kimilucky-ic/flyvis-fpga-competition/src/neural/README.md

# Final neural compute source

Eight RTL modules and fifty unchanged memory/map images for the current complete-network implementation. Arithmetic, topology and update order are unchanged by directory consolidation. Original/exported hashes are in ../../build/portable/relocation_manifest.json (its historical `neural/` labels now resolve to this directory).

Use ../../build/portable/prepare.py and its documented stages; do not launch isolated legacy scripts. Runtime firmware remains paired in ../../board/runtime/app/bundle/.
