kimilucky-ic/flyvis-fpga-competition/report/release_review.md

# Repository delivery and publication boundary

Updated 2026-11-02. The source delivery exists in `kimilucky-ic/flyvis-fpga-competition`; it is now PUBLIC (verified 2026-11-02); the original conversations remain withdrawn. Current completion adds a corrected seven-page report, selected safe current engineering exchanges, official vendor acquisition instructions and aligned entry documentation. This update does not change repository visibility.

## Evidence retained

Existing software sample and fresh-session preparation checks, normalized file admission/JS syntax, historical RTL/implementation reports and the saved 1090-step analysis retain their own original evidence levels. Current documentation changes do not rerun or strengthen those results. The original engineering workspace, RAR and accepted neural/runtime/firmware files are untouched. Parent Git commit is the rollback point.

## Public-release blockers

- The 28 ALIENTEK source instances in [third_party_holds.json](third_party_holds.json) and relevant derived artifacts have no verified redistribution grant. Official download links provide a source locator, not a replacement license.
- Current official archive-to-BIT and clean-machine Vivado reproduction have not been validated; exact vendor-derived bytes may require the matching reference revision.
- Earlier private conversations stay withdrawn. [Selected collaboration evidence](ai_collaboration_record.md) contains only short current engineering exchanges and labelled editorial corrections, not a full historical chat export.

The team authorized updating the existing repository materials. This update does not change visibility, run hardware experiments or contact the vendor. Repository contents, current software checks and publication clearance are separate claims.
