kimilucky-ic/flyvis-fpga-competition/third_party_notices.md

# Attribution and licensing

The root MIT license applies to original team-authored contributions only. Third-party code, headers, generated tool files and data retain their upstream notices and terms; the root license does not override them.

FlyVis: https://github.com/TuragaLab/flyvis and Lappalainen et al., Nature (2024), https://doi.org/10.1038/s41586-024-07939-3 . The upstream MIT notice is retained in the current bundle. Model authorship and training belong to the original authors. Exported model provenance is in original_model_provenance.json.

AMD Vivado/PYNQ IP and ALIENTEK board camera example dependencies remain subject to their original licenses. Reconstruct vendor IP with licensed Vivado and use the original working PYNQ2.7 vendor SD image. This repository does not license or distribute Vivado, the SD image or vendor tool binaries. Retain source-header notices when reusing historical examples.
