kimilucky-ic/flyvis-fpga-competition/report/ai_engineering_cases.md

# FlyVis工程协作案例（脱敏节选）

更新：2026-10-30。本页补充实际研发内容。前两个案例仅摘取已核对的短提示和对应回答；问题、修正与结果段为编辑整理。后两个案例全部为工程档案摘要，没有补写缺失的对话。省略全部本机路径、人员信息、私人言论、会话标识、认证信息及无关上下文；未恢复完整历史聊天。

本轮仅整理保存的材料，没有重跑GPU、摄像头、板卡或Vivado。证据级别随原记录保留。历史版本的成功和限制不自动等于当前版本验收。

## 案例1：恢复正确的固件加载与内存申请顺序

记录形式：短原文节选＋工程整理。

用户提示（原文节选）：

> 同意，恢复以前成功的顺序，先加载固件再申请内存，失败就退出不启动计算。把错误提示也改好，先做软件验证，改完给我新的Notebook，板端我来运行，别再让我反复试错了。

模型回答（原文节选）：

> **核对身份和独占状态 → 加载固件 → 实际申请并校验内存 → 成功后才配置、启动神经计算。**

**问题与反馈（整理）：**原流程在加载Overlay前申请内存，PYNQ 2.7返回Overlay is not downloaded；CmaFree也不能单独作为实际分配能力的判断。

**修正方法（整理）：**恢复依赖顺序，申请失败即退出；错误说明必须区分固件是否加载、内存是否分配及神经计算是否开始。

**验证与边界（整理）：**原保存报告记录6项初始化/失败路径软件测试、3类输入提示检查，Python 3.8语法及配对身份检查通过。实际内存申请当时未执行；不能称为板测通过。

[对应工程证据](evidence/initialization_cpu.json)

## 案例2：让T4/T5显示保留真实数值与科学含义

记录形式：短原文节选＋工程整理。

用户提示（原文节选）：

> 那就把中央T4/T5八个亚型的曲线和这个方向偏好解释加到现有GUI右边文字区，别再只显示721节点均值，不改布局、不重跑实验，让评委能直接看懂亮边缘和暗边缘分别是谁在响应。把节点均值换成中央T4T5啊。

模型回答（原文节选）：

> **已经改好：原GUI右侧的八条曲线，已从“每类721节点均值”换成“中央T4/T5八个亚型的真实活动”。布局不变，不需要重跑实验。**

**问题与反馈（整理）：**空间均值可能掩盖局部响应；带符号的模型活动、整流后的展示曲线和方向偏好容易被混淆。

**修正方法（整理）：**在该历史版本显示中央节点的max(activity,0)曲线，同时保留带符号原始值；不做逐帧归一化，不把历史GPU方向分析标成当前运行新算的指标。

**验证与边界（整理）：**这是历史GUI修改的对话证据；原回答提到970步既有ON/OFF数据核对，本次未重新执行该核对，不将对话中的数值单独提升为新验证结果。后续区域均值版本有独立定义，不能与本案例混称。

[对应工程证据](https://github.com/kimilucky-ic/flyvis-fpga-competition/tree/archive/full-development-before-slim/src/flyvis_runtime/fly/viewer/competition_full_pl.js)

## 案例3：FP32优化：数值正确之后仍须修复布线时序

记录形式：工程档案摘要，非逐字对话。

**问题与反馈（整理）：**保存的工程说明记载：首版跳过无效空间坐标的候选数值通过，但100MHz完整SoC布线WNS为−1.171ns，80个建立端点失败。原始完整提示与回答未纳入本次材料。

**修正方法（整理）：**为裁剪行描述符增加寄存器，使用pending标签和ready标志对齐同步读取；在背压下保持描述符、映射与标签同步，保留原源节点ID和边顺序。

**验证与边界（整理）：**保存比较报告：45,669节点、1,513,231条有序边；基线2,284,304周期，候选2,201,418周期，减少3.6285%；修复版完整SoC布线WNS+0.139ns、建立端点失败0。周期改善和布线结果均不是物理板速实测。

[对应工程证据](evidence/fp32_pipeline_comparison.json)

## 案例4：DDR环形记录：减少内存，保留持久化后释放

记录形式：工程档案摘要，非逐字对话。

**问题与反馈（整理）：**持续记录需要有限内存；不能覆盖尚未可靠保存的状态，也不能把PC接收确认误当成板端槽位释放。原始完整提示与回答未纳入本次材料。

**修正方法（整理）：**64槽循环记录，按16步批处理持久化；前台只在保存线程确认持久化完成后释放连续记录。槽满产生背压，回绕不重置神经状态，错误或未知状态不自动重试。

**验证与边界（整理）：**保存的CPU/Verilator报告记录：DDR由95.953125MiB改为11.5MiB；完整网络5步核对228,345状态字、差异0。另有既有1090步操作者记录的离线审核，属于不同证据，不能把本报告当作新实板运行。

[对应工程证据](evidence/ddr_ring_summary.json)

## 阅读与复核

[结构化案例](ai_engineering_cases.json)保留相同内容。[此前交付记录](ai_collaboration_record.md)仅用于仓库核查，不再作为主要研发案例。脱敏后的短节选不代表提供了完整历史原始对话。
