kimilucky-ic/flyvis-fpga-competition/report/collaboration_selected.md

# 脱敏研发协作记录

正式报告中的本路径对应[四个工程案例](ai_engineering_cases.md)，短原文与档案摘要分列；[离线阅读版](ai_engineering_cases.html)。不提供完整私人对话。
