kimilucky-ic/flyvis-fpga-competition/report/ai_workflow.md

# AI工程协作材料

主要研发案例见[脱敏工程案例](ai_engineering_cases.md)，[离线阅读版](ai_engineering_cases.html)可直接本机打开。[结构化记录](ai_engineering_cases.json)与正文一致。

两个案例有短提示/回答原文节选，两个为明确标记的工程档案摘要；不编造缺失回答，不恢复完整私人聊天。[既有仓库交付记录](ai_collaboration_record.md)单独保留。早先JSON均仍为回顾摘要。

本页不改变已有报告的原证据级别；没有运行任何设备或新科学实验。
