kimilucky-ic/flyvis-fpga-competition/report/ai_collaboration_record.md

# Selected engineering collaboration record — 2026-10-29

Scope: repository completeness and documentation delivery only. The quotations below are short verbatim excerpts from the current task, selected for the user's request to complete the GitHub deliverable. All feedback and correction paragraphs are editorial summaries, not reconstructed historical dialogue. This is not a full transcript or proof of complete historical AI records. Earlier withdrawn conversations stay withdrawn.

## Case 1: scope, repository visibility and actual upload verification

User instruction (verbatim):

> 不用你只需要管github上有没有提交完全

Assistant response (verbatim):

> 明白，只核查GitHub仓库：确认代码、报告、验证数据、构建与运行说明、Skill是否都已推送，以及有没有漏传或过时内容。不检查比赛官网，也不改仓库公开状态。

Actual tool feedback (short verbatim excerpts):

```text
GitHub API error 404
"visibility":"PRIVATE"
"sha":"064c1606684568d5976b82cf9acce2fc8d9ddcef"
"files":10754
"truncated":false
```

Correction and verification (summary): the connected API returned 404 for the private repository. That was not treated as proof that the repository or files were missing. The already-authorized GitHub CLI account read the repository metadata, main commit and full recursive tree. The remote commit matched the local reviewed commit. Read-only verification confirmed the runtime entry and nine report files. Visibility stayed private. This was a delivery check, not a hardware test.

## Case 2: complete the deliverable without restoring private conversations

User instruction (verbatim):

> 那就把这些都补上

Assistant response (verbatim):

> 我会补齐GitHub里的报告、说明和依赖获取步骤，先核实哪些厂家文件已有明确许可。AI协作部分只选与工程有关的脱敏记录，不恢复整段私人聊天；无法确认的许可和复建结果会如实标明。仓库继续保持私有。

Implementation and verification (summary): preserve the accepted neural, firmware and runtime files; correct outdated README/reproduction statements; add the seven-page report with current repository visibility and record scope; add official vendor acquisition instructions and the existing 56-file identity check. File/link/hash checks, PDF rendering and remote-commit checks are the intended acceptance for this documentation change. No fabricated past model answers or new physical results are added.

## Workflow and boundaries

Human sets scope → inspect actual files and source evidence → preserve accepted code → make minimal documentation changes → validate links, hashes and rendered report → inspect the exact commit → push to the same private repository → verify remote commit. No autonomous agent or device operation is required. A failed/unknown experiment is never retried by this documentation workflow. The quoted exchanges describe this delivery task; older Skill cases retain their own evidence and limitations.
