kimilucky-ic/flyvis-fpga-competition/skill/report_extract.md

# 可并入设计报告的Skill提炼说明

## 提炼来源

本包来自板级交互、工具链复位/位宽问题、图与数值契约、量化比较、GPU/PL反馈、展示对齐、受控替换、能耗口径及证据保留等实际工作。具体失败、纠正及历史报告对应关系见14项validation.md、collaboration-records.md和source_review_20261018.md；后两者为整理摘要，不是完整原对话。

## 如何验证有效

先确认原案例的目标/版本/输入和输出身份，再保留成功与失败，不以console PASS单独作证明。包内原始记录与摘要逐项标注，source_manifest.json记录hash。案例包含实际板上回放、实际GPU运算、CPU对照、RTL仿真和估算，各自范围分别表述。2026-10-21仅做文件/格式/来源审核，没有新板测或模型计算。

## 如何确定边界

量化任务分数不等价于完整内部状态一致；回放不等于闭环；估算不等于板级功耗；特定GPU/板卡成功不等于跨板通用。Windows路径只有用户观察，原失败日志不足。所有参数化模板的独立复用尚未完成，见validation_gaps.md。

## 他人使用路径

从README.md选择相应项，填写usage.md所需目标与契约，按skill.md步骤在获准任务中使用，保留reuse_record.json记录。用预先确定的门限和原始证据判断成功/失败，不照搬本项目的地址/bitstream/hash。完整历史实验的工程、数据和工具须另行合法获得；本包不是完整实验源码。

此节可纳入3.3.5.3的“提炼过程”，不能代替整份设计报告或完整LLM交互附件。
