kimilucky-ic/flyvis-fpga-competition/build/portable/vendor_file_map.md

# Platform dependency file map

All 56 matching files are already included in `src/vendor`; no vendor download is required for the offline prepare step. Run from the repository root:

```text
python build/portable/prepare.py --vendor-dir src/vendor --output ../flyvis_build
```

The first column is the exact path relative to the accepted vendor project working directory, not an independently verified location inside today's manufacturer archive. Official download and version limits remain in [vendor dependency review](../vendor_dependency_review.md). Some metadata is generated by the vendor project. The archive-internal paths have not been verified, so they are not invented here.

| Required vendor-relative file | Bundled file | SHA256 |
| --- | --- | --- |
| `base.bd` | [src/vendor/base.bd](../../src/vendor/base.bd) | `a08877266a865cdf75d5c5047701cd81b9b72199ded3a373683df26e48c40b7c` |
| `base.xdc` | [src/vendor/base.xdc](../../src/vendor/base.xdc) | `c79dcbc456922482ab0d6adf72560cd75552ea30a078e663b3640884c2776b49` |
| `ov5640_lcd.tcl` | [src/vendor/ov5640_lcd.tcl](../../src/vendor/ov5640_lcd.tcl) | `69524d4433c1b1718ea8e8ad9bf8af4eb3550cee7b4196bf206c34afbb5335c9` |
| `ov5640_lcd.xdc` | [src/vendor/ov5640_lcd.xdc](../../src/vendor/ov5640_lcd.xdc) | `c62a2a8bc13933be10ddce5fbaf6409dd815fe9937c075d44b8e259e6da00182` |
| `bd_xci/ip/base_auto_cc_0/base_auto_cc_0.xci` | [src/vendor/bd_xci/ip/base_auto_cc_0/base_auto_cc_0.xci](../../src/vendor/bd_xci/ip/base_auto_cc_0/base_auto_cc_0.xci) | `876a5273ebf8daf60ccf3d9f35fd5de3859664417b6a995de6d6e4e8c88ef673` |
| `bd_xci/ip/base_auto_pc_0/base_auto_pc_0.xci` | [src/vendor/bd_xci/ip/base_auto_pc_0/base_auto_pc_0.xci](../../src/vendor/bd_xci/ip/base_auto_pc_0/base_auto_pc_0.xci) | `1a972976e8166c1a9832acf68daef37545088bcb073cfe2463fcb00d0e1b1245` |
| `bd_xci/ip/base_auto_pc_1/base_auto_pc_1.xci` | [src/vendor/bd_xci/ip/base_auto_pc_1/base_auto_pc_1.xci](../../src/vendor/bd_xci/ip/base_auto_pc_1/base_auto_pc_1.xci) | `9bd3e011a3799e453582a2242b76835d4c50f745ad4b2efdc3556565624862a3` |
| `bd_xci/ip/base_auto_pc_2/base_auto_pc_2.xci` | [src/vendor/bd_xci/ip/base_auto_pc_2/base_auto_pc_2.xci](../../src/vendor/bd_xci/ip/base_auto_pc_2/base_auto_pc_2.xci) | `189b9f4f207cca44645f92652aeda60a6d7c0008c4d70b3adb8a63cfcca7abe9` |
| `bd_xci/ip/base_auto_pc_3/base_auto_pc_3.xci` | [src/vendor/bd_xci/ip/base_auto_pc_3/base_auto_pc_3.xci](../../src/vendor/bd_xci/ip/base_auto_pc_3/base_auto_pc_3.xci) | `018e704e2996141e6e7452021072cc91f4ca0f33d392af949b15e461cfa5fcb4` |
| `bd_xci/ip/base_auto_pc_4/base_auto_pc_4.xci` | [src/vendor/bd_xci/ip/base_auto_pc_4/base_auto_pc_4.xci](../../src/vendor/bd_xci/ip/base_auto_pc_4/base_auto_pc_4.xci) | `873a3f6a3a74e39cc77109172817aa0b060ac0e5f9ed5b1a45546bb71ba4cff9` |
| `bd_xci/ip/base_auto_us_0/base_auto_us_0.xci` | [src/vendor/bd_xci/ip/base_auto_us_0/base_auto_us_0.xci](../../src/vendor/bd_xci/ip/base_auto_us_0/base_auto_us_0.xci) | `2d16853b1b689a5a18ed43c6b424bd634c9b323ce3ec8877a82c783d6c93b1a6` |
| `bd_xci/ip/base_axi_dynclk_0/base_axi_dynclk_0.xci` | [src/vendor/bd_xci/ip/base_axi_dynclk_0/base_axi_dynclk_0.xci](../../src/vendor/bd_xci/ip/base_axi_dynclk_0/base_axi_dynclk_0.xci) | `13f06caad73cdb752ea823f14c408d3d1ee2ead530aa73e3d1663953becbd809` |
| `bd_xci/ip/base_axi_gpio_0_0/base_axi_gpio_0_0.xci` | [src/vendor/bd_xci/ip/base_axi_gpio_0_0/base_axi_gpio_0_0.xci](../../src/vendor/bd_xci/ip/base_axi_gpio_0_0/base_axi_gpio_0_0.xci) | `3b412bda122c1f71cb6d23a0378c91464b1177f3a1ff04484494a7179855058f` |
| `bd_xci/ip/base_axi_intc_0_0/base_axi_intc_0_0.xci` | [src/vendor/bd_xci/ip/base_axi_intc_0_0/base_axi_intc_0_0.xci](../../src/vendor/bd_xci/ip/base_axi_intc_0_0/base_axi_intc_0_0.xci) | `3c6d839d02bd65094d65f942e834f80d036ea0469ca0546a2a899ffcb0dcc1da` |
| `bd_xci/ip/base_axi_interconnect_0_0/base_axi_interconnect_0_0.xci` | [src/vendor/bd_xci/ip/base_axi_interconnect_0_0/base_axi_interconnect_0_0.xci](../../src/vendor/bd_xci/ip/base_axi_interconnect_0_0/base_axi_interconnect_0_0.xci) | `10ce913ca64b048b437295b72b69edaa7951d376337413e566102f6b58a4c169` |
| `bd_xci/ip/base_axi_mem_intercon_0/base_axi_mem_intercon_0.xci` | [src/vendor/bd_xci/ip/base_axi_mem_intercon_0/base_axi_mem_intercon_0.xci](../../src/vendor/bd_xci/ip/base_axi_mem_intercon_0/base_axi_mem_intercon_0.xci) | `4609fbb34488f86272514b471ad2e7fb21c66cc44762a15fb1c6b0231a9b783b` |
| `bd_xci/ip/base_axi_vdma_0/base_axi_vdma_0.xci` | [src/vendor/bd_xci/ip/base_axi_vdma_0/base_axi_vdma_0.xci](../../src/vendor/bd_xci/ip/base_axi_vdma_0/base_axi_vdma_0.xci) | `adf6904985197af17f55e6bd5eb9d3ecccb2fb6dd8be215f28ad553c3c56bc1f` |
| `bd_xci/ip/base_cam_iic_0/base_cam_iic_0.xci` | [src/vendor/bd_xci/ip/base_cam_iic_0/base_cam_iic_0.xci](../../src/vendor/bd_xci/ip/base_cam_iic_0/base_cam_iic_0.xci) | `a938c62e9eef66d62684416df0248b367aca019d196c7dcb49213c700c22db75` |
| `bd_xci/ip/base_cmos_capture_data_0_0/base_cmos_capture_data_0_0.xci` | [src/vendor/bd_xci/ip/base_cmos_capture_data_0_0/base_cmos_capture_data_0_0.xci](../../src/vendor/bd_xci/ip/base_cmos_capture_data_0_0/base_cmos_capture_data_0_0.xci) | `cee6e86c9bb4aa041c20bef8bcb187ae6211258d5fc04d242c2c1f7196109777` |
| `bd_xci/ip/base_concat_interrupts_0/base_concat_interrupts_0.xci` | [src/vendor/bd_xci/ip/base_concat_interrupts_0/base_concat_interrupts_0.xci](../../src/vendor/bd_xci/ip/base_concat_interrupts_0/base_concat_interrupts_0.xci) | `c181f5578359626c630e6d4b16b74b14ec433a1fc7142b25252784d2fb742164` |
| `bd_xci/ip/base_m00_regslice_2/base_m00_regslice_2.xci` | [src/vendor/bd_xci/ip/base_m00_regslice_2/base_m00_regslice_2.xci](../../src/vendor/bd_xci/ip/base_m00_regslice_2/base_m00_regslice_2.xci) | `20b769e18d832bd5410f274f6550da465165891337e2d4939a2901b562285073` |
| `bd_xci/ip/base_m00_regslice_3/base_m00_regslice_3.xci` | [src/vendor/bd_xci/ip/base_m00_regslice_3/base_m00_regslice_3.xci](../../src/vendor/bd_xci/ip/base_m00_regslice_3/base_m00_regslice_3.xci) | `d7efbbe0ce530108f635a32cc7062424b74c04510958aa79c690dba6a21f6485` |
| `bd_xci/ip/base_m01_regslice_2/base_m01_regslice_2.xci` | [src/vendor/bd_xci/ip/base_m01_regslice_2/base_m01_regslice_2.xci](../../src/vendor/bd_xci/ip/base_m01_regslice_2/base_m01_regslice_2.xci) | `7d8a0987f238db25c8dc28da77175345a96f28004b8f76a00ba0640b16dd9a96` |
| `bd_xci/ip/base_m01_regslice_3/base_m01_regslice_3.xci` | [src/vendor/bd_xci/ip/base_m01_regslice_3/base_m01_regslice_3.xci](../../src/vendor/bd_xci/ip/base_m01_regslice_3/base_m01_regslice_3.xci) | `ace3698f7b0aaebd0c8ec60928ab50b3352b33a182a8d93f773580b9d049c85c` |
| `bd_xci/ip/base_m02_regslice_2/base_m02_regslice_2.xci` | [src/vendor/bd_xci/ip/base_m02_regslice_2/base_m02_regslice_2.xci](../../src/vendor/bd_xci/ip/base_m02_regslice_2/base_m02_regslice_2.xci) | `412041f95273f3304c281fedacb7509ce924fbb0c42f146e5b8d52bcb2ed4dd1` |
| `bd_xci/ip/base_m02_regslice_3/base_m02_regslice_3.xci` | [src/vendor/bd_xci/ip/base_m02_regslice_3/base_m02_regslice_3.xci](../../src/vendor/bd_xci/ip/base_m02_regslice_3/base_m02_regslice_3.xci) | `3824318fd6a961f45b3762fc7e27b0da2063ecfffa70cf2022882ef372b3324d` |
| `bd_xci/ip/base_m03_regslice_0/base_m03_regslice_0.xci` | [src/vendor/bd_xci/ip/base_m03_regslice_0/base_m03_regslice_0.xci](../../src/vendor/bd_xci/ip/base_m03_regslice_0/base_m03_regslice_0.xci) | `41055011f7a0cc3e82337f41680245924a618aa7f732d837a2256ac224120205` |
| `bd_xci/ip/base_proc_sys_reset_pixelclk_0/base_proc_sys_reset_pixelclk_0.xci` | [src/vendor/bd_xci/ip/base_proc_sys_reset_pixelclk_0/base_proc_sys_reset_pixelclk_0.xci](../../src/vendor/bd_xci/ip/base_proc_sys_reset_pixelclk_0/base_proc_sys_reset_pixelclk_0.xci) | `a2f092c95a726b9134bc3574a350d8fbba73089b3a574dae3e7ae403ee0ac927` |
| `bd_xci/ip/base_ps7_0_0/base_ps7_0_0.xci` | [src/vendor/bd_xci/ip/base_ps7_0_0/base_ps7_0_0.xci](../../src/vendor/bd_xci/ip/base_ps7_0_0/base_ps7_0_0.xci) | `296dd4aa0713a3572188b0aeb74e1830dcd1202ac5bb84235bfc0cbf590debbf` |
| `bd_xci/ip/base_ps7_0_axi_periph_0/base_ps7_0_axi_periph_0.xci` | [src/vendor/bd_xci/ip/base_ps7_0_axi_periph_0/base_ps7_0_axi_periph_0.xci](../../src/vendor/bd_xci/ip/base_ps7_0_axi_periph_0/base_ps7_0_axi_periph_0.xci) | `b547bf2d08c993f7331debb627985f607981916634adcb776773edacfc1c1c26` |
| `bd_xci/ip/base_rgb2lcd_0_0/base_rgb2lcd_0_0.xci` | [src/vendor/bd_xci/ip/base_rgb2lcd_0_0/base_rgb2lcd_0_0.xci](../../src/vendor/bd_xci/ip/base_rgb2lcd_0_0/base_rgb2lcd_0_0.xci) | `8d06bdd287cc67e49084138b51e9bf99f478b52b531e057aec5f7675fb2357e8` |
| `bd_xci/ip/base_rst_ps7_0_fclk0_0/base_rst_ps7_0_fclk0_0.xci` | [src/vendor/bd_xci/ip/base_rst_ps7_0_fclk0_0/base_rst_ps7_0_fclk0_0.xci](../../src/vendor/bd_xci/ip/base_rst_ps7_0_fclk0_0/base_rst_ps7_0_fclk0_0.xci) | `e82541682ff0c397d4ca124e348402ddb026a981aba2602c5b94ed21b6e1ea20` |
| `bd_xci/ip/base_rst_ps7_0_fclk1_0/base_rst_ps7_0_fclk1_0.xci` | [src/vendor/bd_xci/ip/base_rst_ps7_0_fclk1_0/base_rst_ps7_0_fclk1_0.xci](../../src/vendor/bd_xci/ip/base_rst_ps7_0_fclk1_0/base_rst_ps7_0_fclk1_0.xci) | `253af30bdf35341863d3cec8c0e89d903274576690f07d042de1753ca876cdce` |
| `bd_xci/ip/base_s00_regslice_2/base_s00_regslice_2.xci` | [src/vendor/bd_xci/ip/base_s00_regslice_2/base_s00_regslice_2.xci](../../src/vendor/bd_xci/ip/base_s00_regslice_2/base_s00_regslice_2.xci) | `6b03c90554ffd153f9f110877b44eb5a4f0a4a5ae21577932e1713e332c3f3ce` |
| `bd_xci/ip/base_s00_regslice_3/base_s00_regslice_3.xci` | [src/vendor/bd_xci/ip/base_s00_regslice_3/base_s00_regslice_3.xci](../../src/vendor/bd_xci/ip/base_s00_regslice_3/base_s00_regslice_3.xci) | `15a16cae2b5bf8d2a000b2dc81300befac8c0d4a79d4bc2b9c24d13f0f6dad02` |
| `bd_xci/ip/base_vtc_out_0/base_vtc_out_0.xci` | [src/vendor/bd_xci/ip/base_vtc_out_0/base_vtc_out_0.xci](../../src/vendor/bd_xci/ip/base_vtc_out_0/base_vtc_out_0.xci) | `21d71ab9f3961838041e2b1c4ff924b39953d20c081c956767d6db5670a85e03` |
| `bd_xci/ip/base_v_axi4s_vid_out_0_0/base_v_axi4s_vid_out_0_0.xci` | [src/vendor/bd_xci/ip/base_v_axi4s_vid_out_0_0/base_v_axi4s_vid_out_0_0.xci](../../src/vendor/bd_xci/ip/base_v_axi4s_vid_out_0_0/base_v_axi4s_vid_out_0_0.xci) | `4ea7f2960c4be40b68614bd73de18ff6b9539ee7910f6e0a9071d95231f4eef1` |
| `bd_xci/ip/base_v_vid_in_axi4s_0_0/base_v_vid_in_axi4s_0_0.xci` | [src/vendor/bd_xci/ip/base_v_vid_in_axi4s_0_0/base_v_vid_in_axi4s_0_0.xci](../../src/vendor/bd_xci/ip/base_v_vid_in_axi4s_0_0/base_v_vid_in_axi4s_0_0.xci) | `106e570c43629115a344e1dd4d0313a85c7d2553e9556b57dd7c2ade082f7080` |
| `bd_xci/ip/base_xbar_4/base_xbar_4.xci` | [src/vendor/bd_xci/ip/base_xbar_4/base_xbar_4.xci](../../src/vendor/bd_xci/ip/base_xbar_4/base_xbar_4.xci) | `523011e3b2e5fde34abfc17314a8aa8cef79eb6868e57680747f3810914ca703` |
| `bd_xci/ip/base_xbar_5/base_xbar_5.xci` | [src/vendor/bd_xci/ip/base_xbar_5/base_xbar_5.xci](../../src/vendor/bd_xci/ip/base_xbar_5/base_xbar_5.xci) | `7613de146bffd0e230c34b98c4975e1cec3532db41b06381bb9a43bb0daf76fa` |
| `bd_xci/ip/base_xbar_6/base_xbar_6.xci` | [src/vendor/bd_xci/ip/base_xbar_6/base_xbar_6.xci](../../src/vendor/bd_xci/ip/base_xbar_6/base_xbar_6.xci) | `44c8112e9759f206b2425ce95f2fb30325e417b628a266d620b746f5a5a9cce4` |
| `bd_xci/ip/base_xlconcat_0_0/base_xlconcat_0_0.xci` | [src/vendor/bd_xci/ip/base_xlconcat_0_0/base_xlconcat_0_0.xci](../../src/vendor/bd_xci/ip/base_xlconcat_0_0/base_xlconcat_0_0.xci) | `879e9cb17226cc0fece6a57e09d0ecdb18ad5f3e572b7e46ec1f236660b5998c` |
| `ip_repo/axi_dynclk_v1_0/component.xml` | [src/vendor/ip_repo/axi_dynclk_v1_0/component.xml](../../src/vendor/ip_repo/axi_dynclk_v1_0/component.xml) | `c48cd36780fcb87a897305d1fcfdd16cf77765425b20a43ca348df62a4ec6af7` |
| `ip_repo/cmos_sensor/component.xml` | [src/vendor/ip_repo/cmos_sensor/component.xml](../../src/vendor/ip_repo/cmos_sensor/component.xml) | `db45ce382b3f938a9ae4bf46b15601b856b9802b15c0bb2736b238dce8dea1a2` |
| `ip_repo/axi_dynclk_v1_0/src/axi_dynclk.vhd` | [src/vendor/ip_repo/axi_dynclk_v1_0/src/axi_dynclk.vhd](../../src/vendor/ip_repo/axi_dynclk_v1_0/src/axi_dynclk.vhd) | `334a8c8bf5fe3baefb4e44fb0de36a5b37248b08c3786bb7308d012810d837df` |
| `ip_repo/axi_dynclk_v1_0/src/axi_dynclk_S00_AXI.vhd` | [src/vendor/ip_repo/axi_dynclk_v1_0/src/axi_dynclk_S00_AXI.vhd](../../src/vendor/ip_repo/axi_dynclk_v1_0/src/axi_dynclk_S00_AXI.vhd) | `504bb82e0706e4c3d650b59736afc41b398aacf0e03e97f3b95b8b594178b7cb` |
| `ip_repo/axi_dynclk_v1_0/src/mmcme2_drp.v` | [src/vendor/ip_repo/axi_dynclk_v1_0/src/mmcme2_drp.v](../../src/vendor/ip_repo/axi_dynclk_v1_0/src/mmcme2_drp.v) | `78dc2dbc3fb937ab12611fe53d236182af43099690407a3432e5ea5bdaf367c8` |
| `ip_repo/axi_dynclk_v1_0/xgui/axi_dynclk_v1_0.tcl` | [src/vendor/ip_repo/axi_dynclk_v1_0/xgui/axi_dynclk_v1_0.tcl](../../src/vendor/ip_repo/axi_dynclk_v1_0/xgui/axi_dynclk_v1_0.tcl) | `a74b7a76f9d288ef3325656081c3d27dbce43999e8db498f875ab2abf48696b3` |
| `ip_repo/axi_dynclk_v1_0/axi_dynclk/data/axi_dynclk.tcl` | [src/vendor/ip_repo/axi_dynclk_v1_0/axi_dynclk/data/axi_dynclk.tcl](../../src/vendor/ip_repo/axi_dynclk_v1_0/axi_dynclk/data/axi_dynclk.tcl) | `a9ffd929f4395aa6bddaa6e37713a6c7b237f20f34f8fd73c01de20e162dce7a` |
| `ip_repo/cmos_sensor/src/cmos_capture_data.v` | [src/vendor/ip_repo/cmos_sensor/src/cmos_capture_data.v](../../src/vendor/ip_repo/cmos_sensor/src/cmos_capture_data.v) | `c042b990b3598a5182c0f7bbffd067b9f617eb7c869511591329badb197d2934` |
| `ip_repo/cmos_sensor/xgui/cmos_capture_data_v1_1.tcl` | [src/vendor/ip_repo/cmos_sensor/xgui/cmos_capture_data_v1_1.tcl](../../src/vendor/ip_repo/cmos_sensor/xgui/cmos_capture_data_v1_1.tcl) | `e0725b60cdc4cd625ee059e557ee3f5569fcd085edf601849e69e4d438080d96` |
| `ip_repo/if/lcd/lcd.xml` | [src/vendor/ip_repo/if/lcd/lcd.xml](../../src/vendor/ip_repo/if/lcd/lcd.xml) | `2c564e27b6dbf6cc80790c165bc5e58cba51738f0a50807ded0591455c7d0069` |
| `ip_repo/if/lcd/lcd_rtl.xml` | [src/vendor/ip_repo/if/lcd/lcd_rtl.xml](../../src/vendor/ip_repo/if/lcd/lcd_rtl.xml) | `4e0c4442a95fa4b2899c62330f9a4f63787bace52c4a72ed742a775bba620b30` |
| `ip_repo/rgb2lcd/ip/rgb2lcd/component.xml` | [src/vendor/ip_repo/rgb2lcd/ip/rgb2lcd/component.xml](../../src/vendor/ip_repo/rgb2lcd/ip/rgb2lcd/component.xml) | `5f498c12615e884583135cefff1597ae9bc707f1b2a98e12ea5adde64ab85e51` |
| `ip_repo/rgb2lcd/ip/rgb2lcd/src/rgb2lcd.v` | [src/vendor/ip_repo/rgb2lcd/ip/rgb2lcd/src/rgb2lcd.v](../../src/vendor/ip_repo/rgb2lcd/ip/rgb2lcd/src/rgb2lcd.v) | `7ebaf7a14cc58cd0db6debdaaeab574d48cb380e58e7e57ba207af304adfd0fc` |
| `ip_repo/rgb2lcd/ip/rgb2lcd/xgui/rgb2lcd_v1_4.tcl` | [src/vendor/ip_repo/rgb2lcd/ip/rgb2lcd/xgui/rgb2lcd_v1_4.tcl](../../src/vendor/ip_repo/rgb2lcd/ip/rgb2lcd/xgui/rgb2lcd_v1_4.tcl) | `f63c4f47062dff207327c8d80ade87c8f1590a217637b750455e7e0ecf95be52` |
