kimilucky-ic/flyvis-fpga-competition/skill/evidence/originals/build.txt

# Resetfix V1 local delivery — 2026-10-12

## Verified state

Independent project: `flyvis-fpga/p4b/r20261012_191002`. Release: `phase4_67_20261010/build/V1_resetfix_20261012_191002`. Vivado2026.1.1 build6605303, device `xc7z020clg400-2`. Full build ended successfully at host local19:20:47; no board operations were performed.

- Full SoC100MHz routed WNS+0.133ns/TNS0, WHS+0.067ns/THS0. Setup and hold failing endpoints0; no_clock0 and unconstrained_internal_endpoints0. Source: release implementation_timing_summary.rpt, sealed in release_manifest.json.
- Routed resources:13,857 LUTs,14,932 registers,14 BRAM tiles,7 DSPs. Scope is full SoC, not OOC IP. Source: implementation_utilization.rpt.
- DRC error/critical-warning checks0;19 warning checks remain across DPOP-1/2, PDCN-1569, REQP-1840, RTSTAT-10. Do not describe this as warning-free. No PS7-6 in completion log.
- Actual HWH: C_EXT_RESET_HIGH1 and C_AUX_RESET_HIGH1; ACTIVE_HIGH aux_reset_in connected exclusively to zero/dout. HLS and interconnect reset outputs are checked. Generated HDL/XML evidence independently agrees.
- Existing HLS V1 sources/ROM/component/OOC identity and existing fixture comparison identity independently rehashed by the finalizer. No new C/RTL simulation was run. Scientific Q22 acceptance remains NOT_GRANTED.
- BIT configuration payload differs from the old build:12 byte differences after excluding the BIT header; new payload SHA256 `2e85cb26d021c400ebd4777929a2b9c5a12c2ed52300122c6441a2688004bd6d`. This demonstrates configuration data changed, not just header timestamps; it does not prove live operation.
- ZIP independently extracted into a new local directory;35 file entries and11 source snapshots verified. XSA embedded BIT/HWH hashes equal released pair. Row0 expected integers retain the original oracle identity. See RESETFIX_DELIVERY_VERIFICATION.json.

## Exact identities

- BIT4045774bytes: `23cf5da15db221f399b54cae95e341e6a90a699c88d321d0a883aecca15f7569`.
- HWH228525bytes: `3ea3f1e27c7b214e0f7a965455799875cbae94fb87bee6455a58ecbed4813f7d`.
- Delivery ZIP4960034bytes: `91c0b730c731a7d27147155b6192d188f75567280b2874e83926f0a7d450442d`.
- Package manifest: `9115abb331e3f5b89a65690061896a44adcb3cf77e9bb55b8686480258302441`.

The release's copied package-builder source is the seal-time snapshot. Packaging verification was subsequently corrected to distinguish release-local files from external HLS sources; actual packaging source is included separately as package_builder_source.py in the ZIP and hashed in its package manifest. Firmware, copied source snapshot and sealed release manifest were not overwritten.

## Next action and remaining boundaries

Operator uploads PYNQ_V1_RESETFIX_20261012_191002.zip to the existing board directory, then runs the separately prepared file-only unpack cell and returns its output. Do not load old firmware or run old attempt cells. New exact load/row0 authorization is required for this changed pair. Keep serial logging active for any future authorized operation. First authorized load must stop and return its result before manually running one row0 request in the same kernel. No retry, reset, COMMIT,32/800 request or GPU closed loop is included.

Live reset release/first AXI response/PL arithmetic recovery have not been verified. Previous whole-system stall's complete causal mechanism remains unverified. No real-board integer PASS, scientific PASS or unedited-video claim. No new Skill: static defect is verified, safe live recovery reproduction remains pending.
