kimilucky-ic/flyvis-fpga-competition/skill/validation_gaps.md

# 单列：缺少验证证据

日期：2026-10-21。此清单是未完成项，不是要求立即运行硬件/EDA/GPU。只有在明确任务范围下补测。格式完整不等于效果已验证。

## 优先补：基线效果证据缺失

- windows-fpga-path-diagnostics：尚缺失败命令、工具版本、首个错误及同输入ASCII对照。现有成功XSim中文路径日志说明不能笼统定因；目前不能声称已验证稳定效果。
- 全14项：这次新增的参数化提示词及陌生使用者独立复用均NOT_RUN。建议在下一次本来就要做、且已经批准的任务中记录一项独立使用；不要只为包装重复启动大工程。
- LLM协作：curated记录不等于完整原始交互；补充原始摘录只覆盖部分案例，逐项完整提示词/回答/自我纠错链仍需选择、去敏并与来源对齐。不能把新编写的提示词模板当作当年真实提示词。

## 各项具体欠缺

1. **zynq-7000-board-operations**：缺独立陌生使用者复用记录；原Notebook完整输出未随包保存。跨题/跨板通用性未验证。

2. **vivado-vitis-toolchain-debugging**：缺另一工程独立套用该流程的记录；未覆盖全部Vivado/Vitis版本。2024.2.2案例须在总报告说明版本与重建脚本。

3. **fpga-board-reference-research**：包内有历史核对报告，但缺原厂手册/原理图对应页与版本的可分发摘录或精确公开获取定位；缺第二硬件修订复核。

4. **fpga-model-equivalence**：包内未包含整个fly数值比较程序、原始长输入和全状态轨迹；不构成fly原网络或所有IEEE输入等价证明。独立套用未做。

5. **fpga-fixed-point-quantization**：缺量化候选的综合/实板证据；递质极性未定。完整图/生成器/向量未打入轻量Skill包，须在具体工程取得合法输入。

6. **windows-fpga-path-diagnostics**：关键缺口：原失败命令/版本/错误日志、保持输入不变的路径对照、可重复成功。按待验证诊断观察列入，不能充当已验证稳定工作流。

7. **pynq-bounded-replay-evidence**：包内附验收报告，不含原数千项ZIP、全部输入oracle或未剪辑现场视频。陌生任务/第二板卡复用及通用PYNQ加分未证明。

8. **gpu-fpga-feedback-transactions**：附大型FINAL_RESULT的来源绑定摘要，不含完整1.37MB原报告及逐步原始事务/故障注入证据。另一后端/独立部署及全部负向路径未在本次复验。

9. **flyvis-demo-data-integration**：包内没有完整GUI和真实模型数据，也未重新启动GUI或接相机；陌生GUI适配和完整负向场景复用未完成。

10. **flyvis-controlled-replacement**：完整训练/测试数据和逐步轨迹未随包；不构成生物恢复、自然视频真值或CNN上FPGA证据。独立任务复用未完成。

11. **fpga-performance-power-accounting**：缺同任务同边界的板级能耗/时延测量及外部校准；因此比较性节能结论未验证。现有GPU遥测原CSV未随包。

12. **fpga-evidence-preserving-cleanup**：包内附最终/恢复结果，未附完整恢复源片段与逐文件前后hash清单；不可据此删除陌生项目。独立恢复演练未做。

13. **flyvis-gpu-reference**：缺干净安装复现及不同GPU/所有刺激覆盖；checkpoint、输入和大数组不随包。不能把特定算子快照作为完整端到端速度。

14. **flyvis-decoder-inference**：缺陌生checkpoint/decoder独立复用及自然视频校准；原脚本/模型权重/输出数组不随包，绝对速度单位和生物行为未验证。

## 奖励与整体交付另行检查

- 通用PYNQ：缺不同题目/板卡的复用证明，属于额外加分；不冒充已经获得。
- UART候选：仍缺可绑定版本/输入/时间的原始板上受控命令—响应记录，不计入正式14项。
- 总比赛仓库：本次未核对公开性、MIT/Apache等许可、完整设计报告、全部构建/板级交付、全仓库命名和从零重建；不得因本Skill包静态通过而宣布总提交合规。活跃工程没有为命名而搬动。
- “完整复现某实验”的材料与“复用诊断流程”的材料不同：本包可离线阅读方法与小型历史记录，但模型/输入/完整工程未随包。不得声称只取本包就能重建所有历史实验。
