kimilucky-ic/flyvis-fpga-competition/skill/flyvis-demo-data-integration/validation.md

# GUI输入/节点/模型时间与后台证据对齐：证据与适用边界

核对日期：2026-10-21。这里审核历史文件，不表示今天重跑了工程。

## 已验证效果／观察

历史同一数据身份首帧14.7106→2.4934秒，并有源身份/浏览器检查；不是完整桌面启动或板端加速。

证据类型：HISTORICAL_CASE_RECORD_NOT_FRESH_SKILL_REUSE。
适用范围、前提和失效条件见 [操作正文](skill.md)；下面的输入模板可换成本队契约和合法数据使用。

## 随包材料

- [demo](../evidence/originals/demo.json): byte_exact_original, source SHA-256 `437251511b5572303193f6ebb71ab1edab5c3aaff6699538c48f2f23b81e1728`.
- [demo_performance](../evidence/originals/demo_performance.json): byte_exact_original, source SHA-256 `12d0ef3bfd2aeed7bc1e680f91c4fe162f78120232e2767e082708abd8150bdf`.

原始位置、字节数、原始hash与包内hash见 [来源清单](../evidence/source_manifest.json)。.txt/.log保存原报告字节；报告中的旧路径、旧“待办”和链接属于当时记录，并非本包执行入口或当前状态。大报告摘要明确标注派生，不冒充完整原证据。

## 缺少的验证材料

包内没有完整GUI和真实模型数据，也未重新启动GUI或接相机；陌生GUI适配和完整负向场景复用未完成。

所有14项都没有在本次文档修订中完成陌生队伍从零复用；格式/文件hash检查不代替这种效果验证。
