kimilucky-ic/flyvis-fpga-competition/skill/gpu-fpga-feedback-transactions/validation.md

# GPU/PL旧态所有权与COMMIT/ACK事务：证据与适用边界

核对日期：2026-10-21。这里审核历史文件，不表示今天重跑了工程。

## 已验证效果／观察

历史A3R1 485步真实闭环报告：2797480候选与2791712反馈词核对，native_H_GPU_updates=0。

证据类型：HISTORICAL_CASE_RECORD_NOT_FRESH_SKILL_REUSE。
适用范围、前提和失效条件见 [操作正文](skill.md)；下面的输入模板可换成本队契约和合法数据使用。

## 随包材料

- [feedback](../evidence/originals/feedback_excerpt.json): selected_json_fields, source SHA-256 `c7cdb55d52a0659ddd1db84f9a58b4587c1b03749f47a82095631fef80ad8328`.

原始位置、字节数、原始hash与包内hash见 [来源清单](../evidence/source_manifest.json)。.txt/.log保存原报告字节；报告中的旧路径、旧“待办”和链接属于当时记录，并非本包执行入口或当前状态。大报告摘要明确标注派生，不冒充完整原证据。

## 缺少的验证材料

附大型FINAL_RESULT的来源绑定摘要，不含完整1.37MB原报告及逐步原始事务/故障注入证据。另一后端/独立部署及全部负向路径未在本次复验。

所有14项都没有在本次文档修订中完成陌生队伍从零复用；格式/文件hash检查不代替这种效果验证。
