kimilucky-ic/flyvis-fpga-competition/skill/pynq-bounded-replay-evidence/validation.md

# PYNQ有界请求、原始证据封存和独立oracle审核：证据与适用边界

核对日期：2026-10-21。这里审核历史文件，不表示今天重跑了工程。

## 已验证效果／观察

历史800/800请求、53600/53600整数匹配，4812清单文件独立复核；不是800步真实反馈或Q22科学精度PASS。

证据类型：HISTORICAL_CASE_RECORD_NOT_FRESH_SKILL_REUSE。
适用范围、前提和失效条件见 [操作正文](skill.md)；下面的输入模板可换成本队契约和合法数据使用。

## 随包材料

- [replay](../evidence/originals/replay.txt): byte_exact_original, source SHA-256 `2546fc463b6bbf3ddcb66ceae50d8c9f76a095a09898fdfba1179c7e3c91114b`.

原始位置、字节数、原始hash与包内hash见 [来源清单](../evidence/source_manifest.json)。.txt/.log保存原报告字节；报告中的旧路径、旧“待办”和链接属于当时记录，并非本包执行入口或当前状态。大报告摘要明确标注派生，不冒充完整原证据。

## 缺少的验证材料

包内附验收报告，不含原数千项ZIP、全部输入oracle或未剪辑现场视频。陌生任务/第二板卡复用及通用PYNQ加分未证明。

所有14项都没有在本次文档修订中完成陌生队伍从零复用；格式/文件hash检查不代替这种效果验证。
