kimilucky-ic/flyvis-fpga-competition/skill/windows-fpga-path-diagnostics/validation.md

# Windows路径兼容性排查线索（待验证）：证据与适用边界

核对日期：2026-10-21。这里审核历史文件，不表示今天重跑了工程。

## 已验证效果／观察

只有用户报告中文目录改为fpga后恢复。附带的历史XSim日志反而证明某次含中文路径的仿真成功，不能宣称中文路径必然失败。

证据类型：USER_REPORTED_OBSERVATION_NOT_REPRODUCED。
适用范围、前提和失效条件见 [操作正文](skill.md)；下面的输入模板可换成本队契约和合法数据使用。

## 随包材料

- [quant_xsim](../evidence/originals/quant_xsim.log): byte_exact_original, source SHA-256 `c5bd81d7807096b473973157ac7e8d3edbbeefb143e51a5331a1e7fea9356f58`.

原始位置、字节数、原始hash与包内hash见 [来源清单](../evidence/source_manifest.json)。.txt/.log保存原报告字节；报告中的旧路径、旧“待办”和链接属于当时记录，并非本包执行入口或当前状态。大报告摘要明确标注派生，不冒充完整原证据。

## 缺少的验证材料

关键缺口：原失败命令/版本/错误日志、保持输入不变的路径对照、可重复成功。按待验证诊断观察列入，不能充当已验证稳定工作流。

所有14项都没有在本次文档修订中完成陌生队伍从零复用；格式/文件hash检查不代替这种效果验证。
