kimilucky-ic/flyvis-fpga-competition/skill/fpga-board-reference-research/validation.md

# 板型、版本、手册/原理图与XDC交叉核对：证据与适用边界

核对日期：2026-10-21。这里审核历史文件，不表示今天重跑了工程。

## 已验证效果／观察

历史报告交叉记录ATK7020器件、50MHz U18、UART T19/J15及P5 3–5/4–6。

证据类型：HISTORICAL_CASE_RECORD_NOT_FRESH_SKILL_REUSE。
适用范围、前提和失效条件见 [操作正文](skill.md)；下面的输入模板可换成本队契约和合法数据使用。

## 随包材料

- [reference](../evidence/originals/reference.txt): byte_exact_original, source SHA-256 `03ba6bb3778ea1303cc1ce2817681878ed1cef89702fba2d5d3977dccab0758e`.

原始位置、字节数、原始hash与包内hash见 [来源清单](../evidence/source_manifest.json)。.txt/.log保存原报告字节；报告中的旧路径、旧“待办”和链接属于当时记录，并非本包执行入口或当前状态。大报告摘要明确标注派生，不冒充完整原证据。

## 缺少的验证材料

包内有历史核对报告，但缺原厂手册/原理图对应页与版本的可分发摘录或精确公开获取定位；缺第二硬件修订复核。

所有14项都没有在本次文档修订中完成陌生队伍从零复用；格式/文件hash检查不代替这种效果验证。
