kimilucky-ic/flyvis-fpga-competition/build/history/README.md

# Historical optimization evidence

[Historical pipeline comparison](fp32_pipeline_comparison.json) contains the preserved 45,669-node/1,513,231-edge CPU/RTL comparison and routed-timing summary. [Core schedule](../../sim/core_schedule.json) has historical cycles and verification scope. [Current implementation](../result.json) is a different full camera SoC build. [Saved operator run](../../board/saved_run_analysis.json) has actual loop timings. These scopes cannot be interchanged; this index does not represent a new experiment.
