kimilucky-ic/flyvis-fpga-competition/(commit log)

2026-10-29 Publish source with engineering summaries only; withdraw conversation excerpts
    [hls_config.cfg]
2026-10-30 Align submission with official src sim build board data skill report layout
    [hls_config.cfg]
2026-11-02 Restore Python constructors and complete official CPU flow runtime
2026-11-02 Publish approved design report and biological visual-circuit poster; align delivery links
2026-11-02 Consolidate latest complete FPGA system; archive full development snapshots
    [hls_config.cfg]
